ETML-ES-SLO/PRJ_2204_Theremin/doc/V2/Fonction_Generer_fre__Createur-0.png

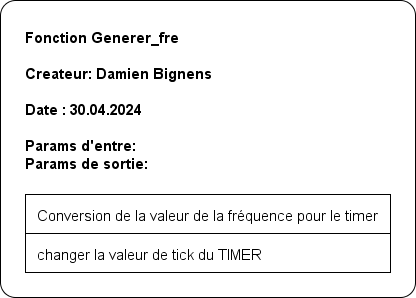
doc/V2/Fonction_Generer_fre__Createur-0.png
