ETML-ES-SLO/PRJ_2204_Theremin/doc/V2/Fonction_Lecture_capteur__Createur-0.png

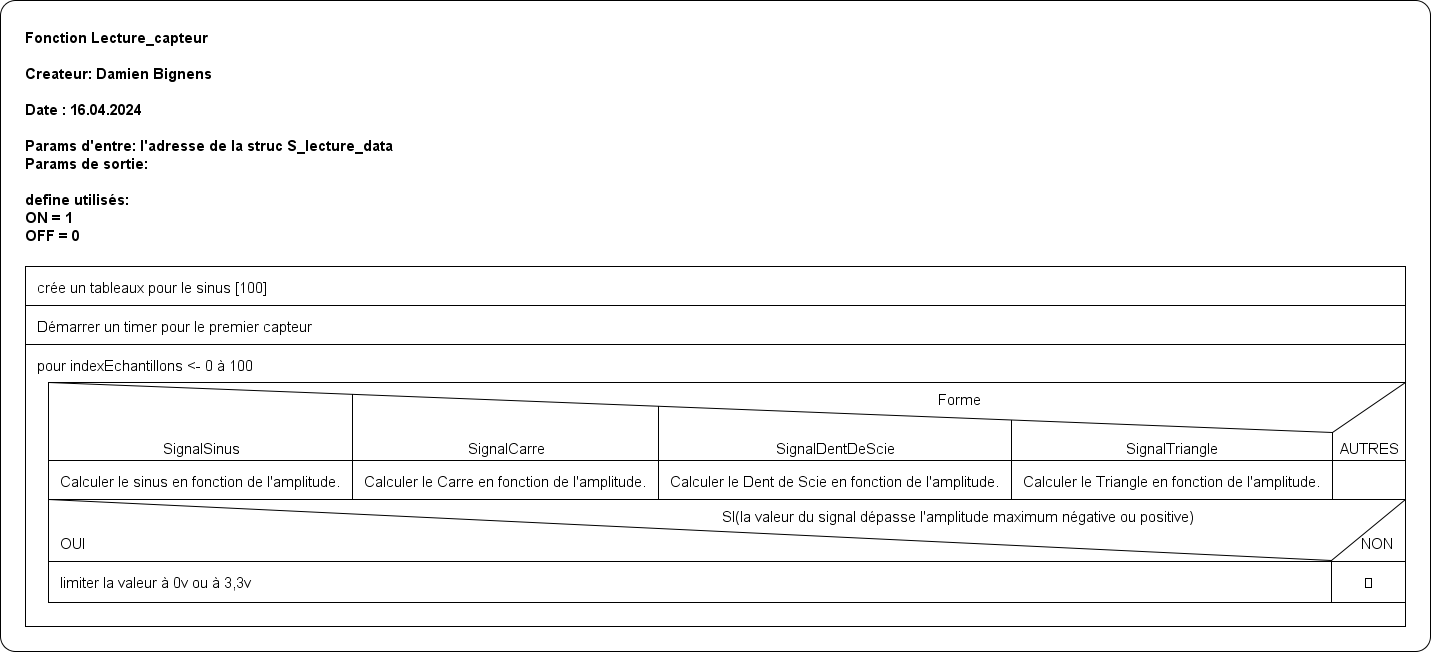
doc/V2/Fonction_Lecture_capteur__Createur-0.png
