ETML-ES-SLO/PRJ_2204_Theremin/doc/V2/Fonction_main__Createur-0.png

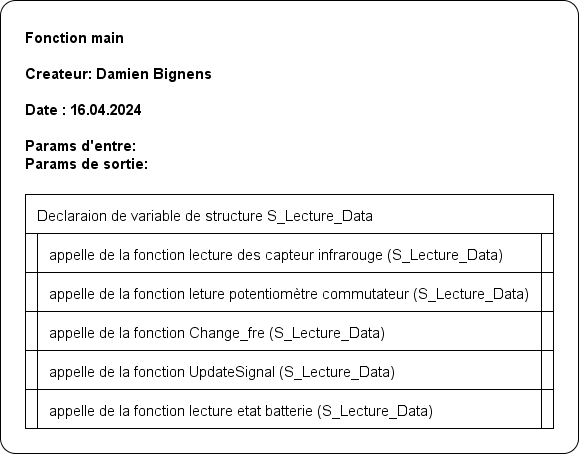
doc/V2/Fonction_main__Createur-0.png
