ETML-ES-SLO/PRJ_2204_Theremin/hard/3D/HC-SR04-UltrasonicSensor v7.step

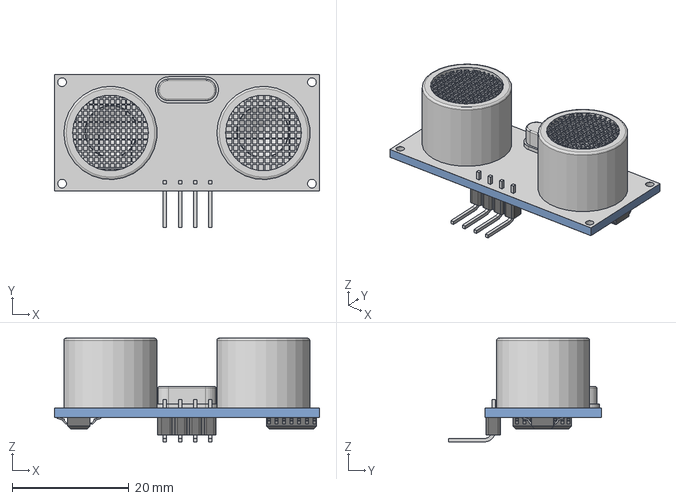
[picture p25: CAD file, 2024-05-14]
hard/3D/HC-SR04-UltrasonicSensor v7.step
45.5 x 26.2 x 17.8 mm
