ETML-ES-SLO/PRJ_2204_Theremin/mec/EvalSworks2022_Chafla/Boitier_Couvercle.SLDPRT

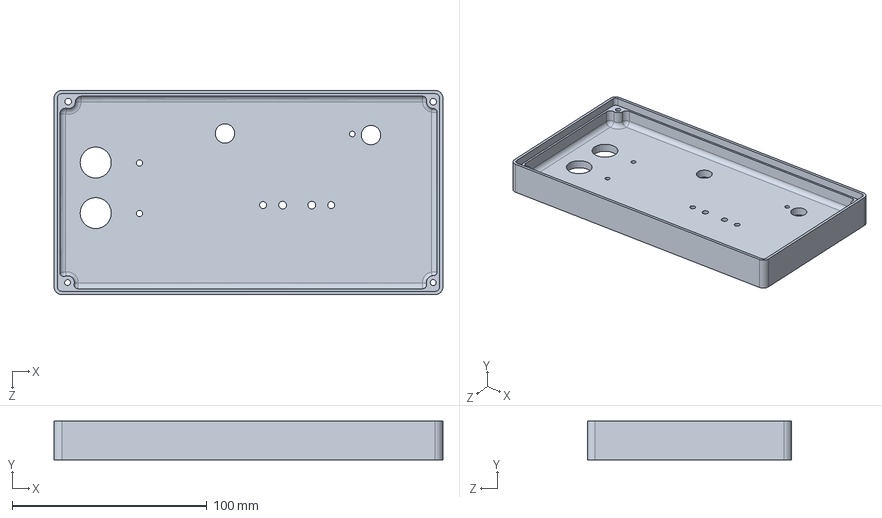
[picture p26: CAD file, 2024-05-14]
mec/EvalSworks2022_Chafla/Boitier_Couvercle.SLDPRT
200.0 x 20.0 x 105.0 mm
