ETML-ES-SLO/PRJ_2204_Theremin/hard/3D/PCB_Flex_Sensor_V.step

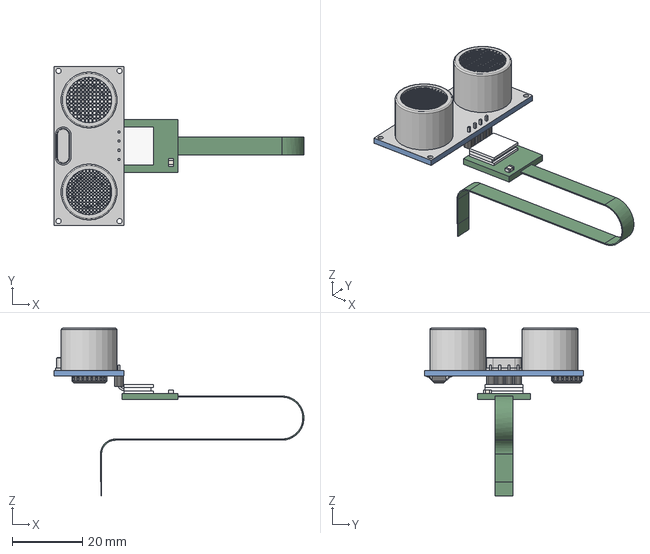
[picture p27: CAD file, 2024-05-14]
hard/3D/PCB_Flex_Sensor_V.step
71.3 x 45.5 x 47.8 mm
