ETML-ES-SLO/PRJ_2204_Theremin/mec/EvalSworks2022_Chafla/Boitier_Base.SLDPRT

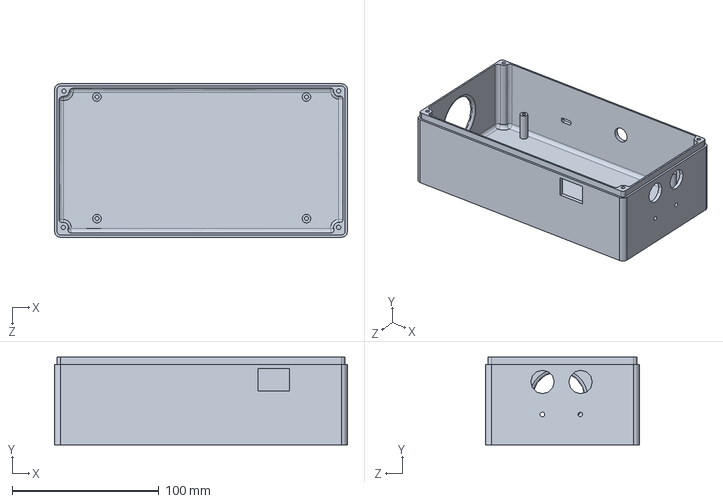
[picture p28: CAD file, 2024-05-14]
mec/EvalSworks2022_Chafla/Boitier_Base.SLDPRT
200.0 x 60.0 x 105.0 mm
