ETML-ES-SLO/PRJ_2204_Theremin/hard/3D/PCB_Flex_Sensor_H2.step

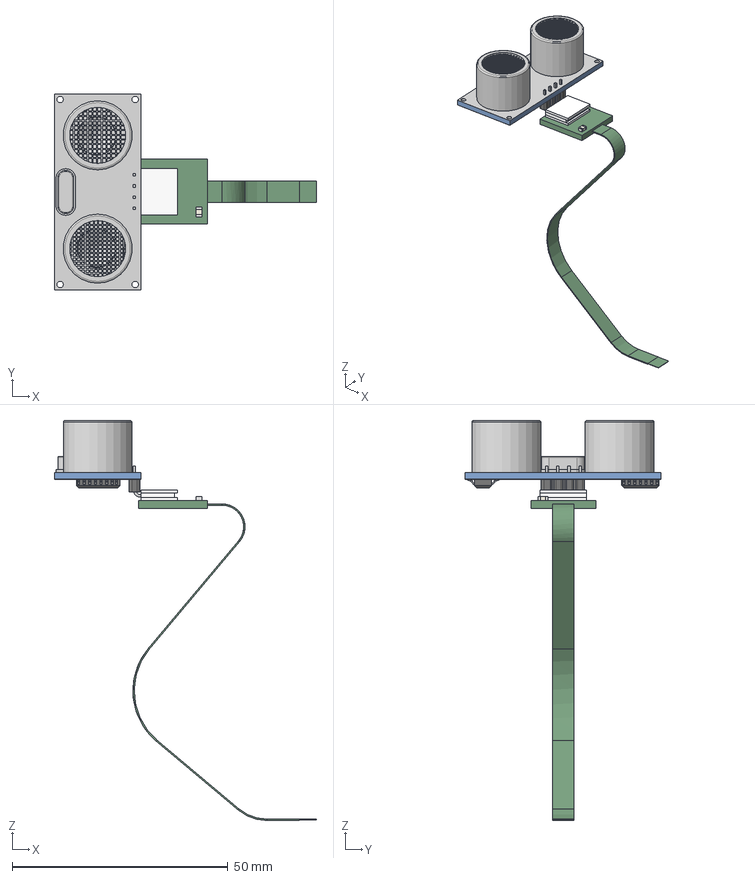
[picture p29: CAD file, 2024-05-14]
hard/3D/PCB_Flex_Sensor_H2.step
60.7 x 45.5 x 92.6 mm
Extruded x 6
HC-SR04-UltrasonicSensor_v7
