ETML-ES-SLO/PRJ_2204_Theremin/hard/3D/CUI_DEVICES_SJ-63073E.sldprt

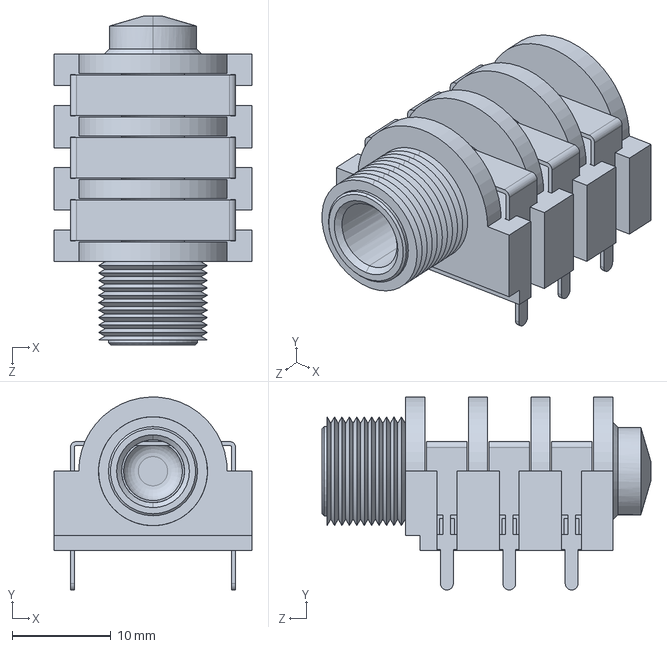
[picture p30: CAD file, 2024-05-14]
hard/3D/CUI_DEVICES_SJ-63073E.sldprt
20.0 x 19.5 x 33.2 mm
