ETML-ES-SLO/PRJ_2204_Theremin/hard/3D/PCB_Sensor_V2.step

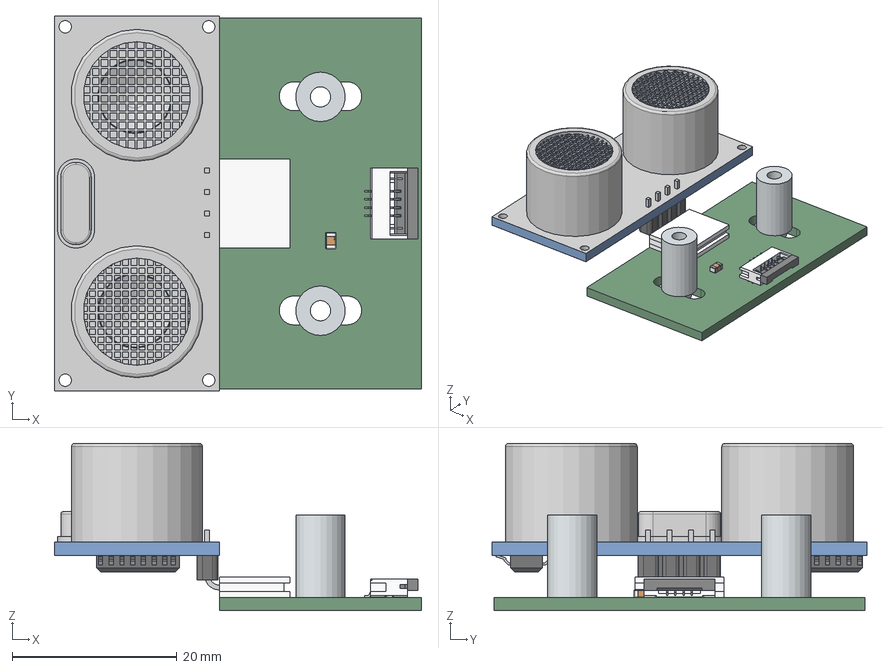
[picture p31: CAD file, 2024-05-14]
hard/3D/PCB_Sensor_V2.step
44.5 x 45.5 x 20.3 mm
6861xx148922_Patte
6861xx148922_Patte2
6861xx148922_Pin x 4
686104148922_Actuator
Extruded x 3
Terminals
Electrode
AVX
HC-SR04-UltrasonicSensor_v7
9774100360R_(rev1) x 2
