ETML-ES-SLO/PRJ_2204_Theremin/hard/3D/PCB_Flex_Sensor_H1.step

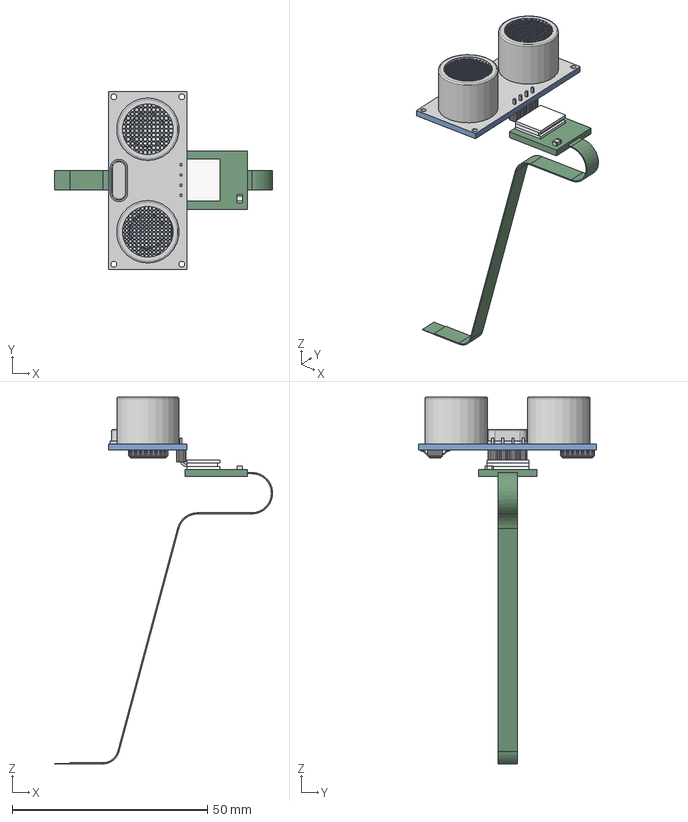
[picture p32: CAD file, 2024-05-14]
hard/3D/PCB_Flex_Sensor_H1.step
55.8 x 45.5 x 93.9 mm
Extruded x 6
HC-SR04-UltrasonicSensor_v7
