ETML-ES-SLO/PRJ_2204_Theremin/hard/3D/Sanjo NCR18650GA.SLDPRT

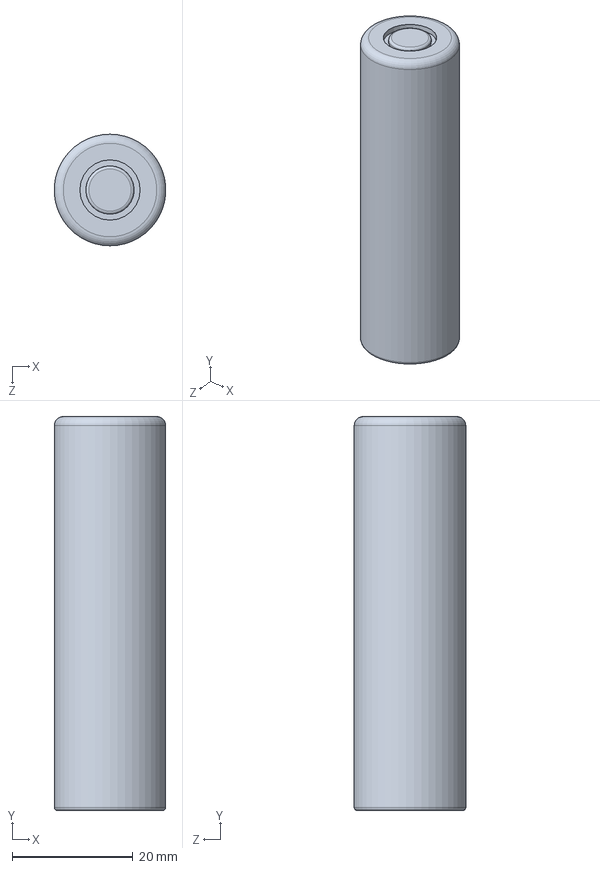
[picture p33: CAD file, 2024-05-14]
hard/3D/Sanjo NCR18650GA.SLDPRT
18.5 x 65.3 x 18.5 mm
