ETML-ES-SLO/PRJ_2204_Theremin/(list of files, cad)

Other CAD files:
hard/3D/Theremin-Boitier_JonathanCHAFLA-Couvercle.SLDPRT
hard/3D/Theremin-Boitier_JonathanCHAFLA.SLDPRT
mec/EvalSworks2022_Chafla/Mise-En-Plan.SLDDRW
