ETML-ES-SLO/PRJ_2204_Theremin/doc/V1/JournalDeTravail-PROJ_Chafla.xlsx

Journal de travail - Projet POBJ
Date | Tâche | Problème rencontré
2023-02-09 | Attribution des sujets de projets
2023-02-16 | Travail effectué pour autres branches suite à des rendus
2023-02-23 | Projet : étude du CdC projet 1737 | Cdc pas très claire
2023-03-02 | TE POBJ Cpp
2023-03-09 | Projet : étude du CdC projet 1737 | Projet pas possible à réaliser informé aux enseignants
2023-03-16 | Attribution nouveau projet Théremin -> reprise projet création dossier local K
2023-03-23 | Projet : étude du projet théremin | Compréhension du schéma
2023-03-30 | Projet : étude du projet théremin, explication fonctionnement des blocs du système
2023-04-06 | Travail effectué pour autres branches suite à des rendus
2023-04-13 | Vacances
2023-04-20 | Vacances
2023-04-27 | TE POBJ C#
2023-05-04 | Projet : étude des périphériques software, design flowcharts
2023-05-11 | Correction test suite à rendu
2023-05-18 | Ascension
2023-05-25 | Projet : mise en forme rapport pour rendu
2023-06-01 | Rendu finale
