ETML-ES-SLO/PRJ_2204_Theremin/hard/Project Outputs for Theremin_Project/DesignDocs/Schematic Prints.PDF

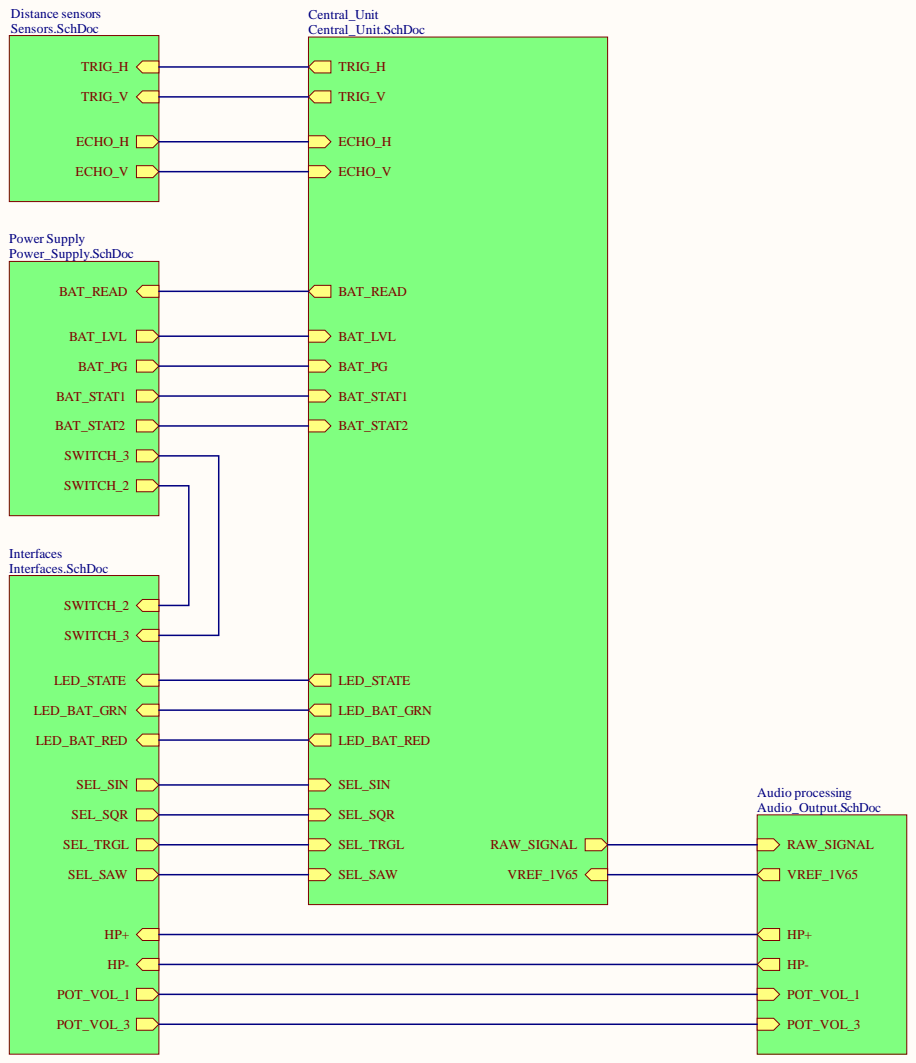
[picture p34: page 1]

Schema_bloc.SchDoc Fichier : | | a

Date : 22.06.2022 | Version :

Heure : 14:36:07 | Auteur : *
Avenue Recordon 1 1004 Lausanne Switzerland | Projet : Theremin_Project.PrjPcb | No :

Nb feuilles | Feuille n°

Chemin : C:\Users\jonchafla\OneDrive - Education Vaud\Users\Jonathan Chafla\ETML\ES\21-22\PCAO\Theremin_Jonathan_Chafla\Schema_bloc.SchDoc

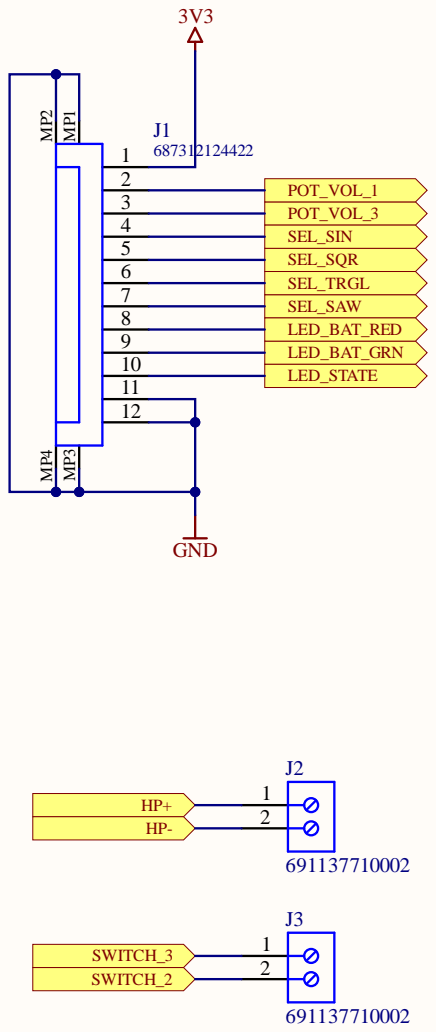
[picture p35: page 2]

Interfaces.SchDoc Fichier : | a

Date : 22.06.2022 | Version :

M.Ricchieri

Chemin : C:\Users\jonchafla\OneDrive - Education Vaud\Users\Jonathan Chafla\ETML\ES\21-22\PCAO\Theremin_Jonathan_Chafla\Interfaces.SchDoc

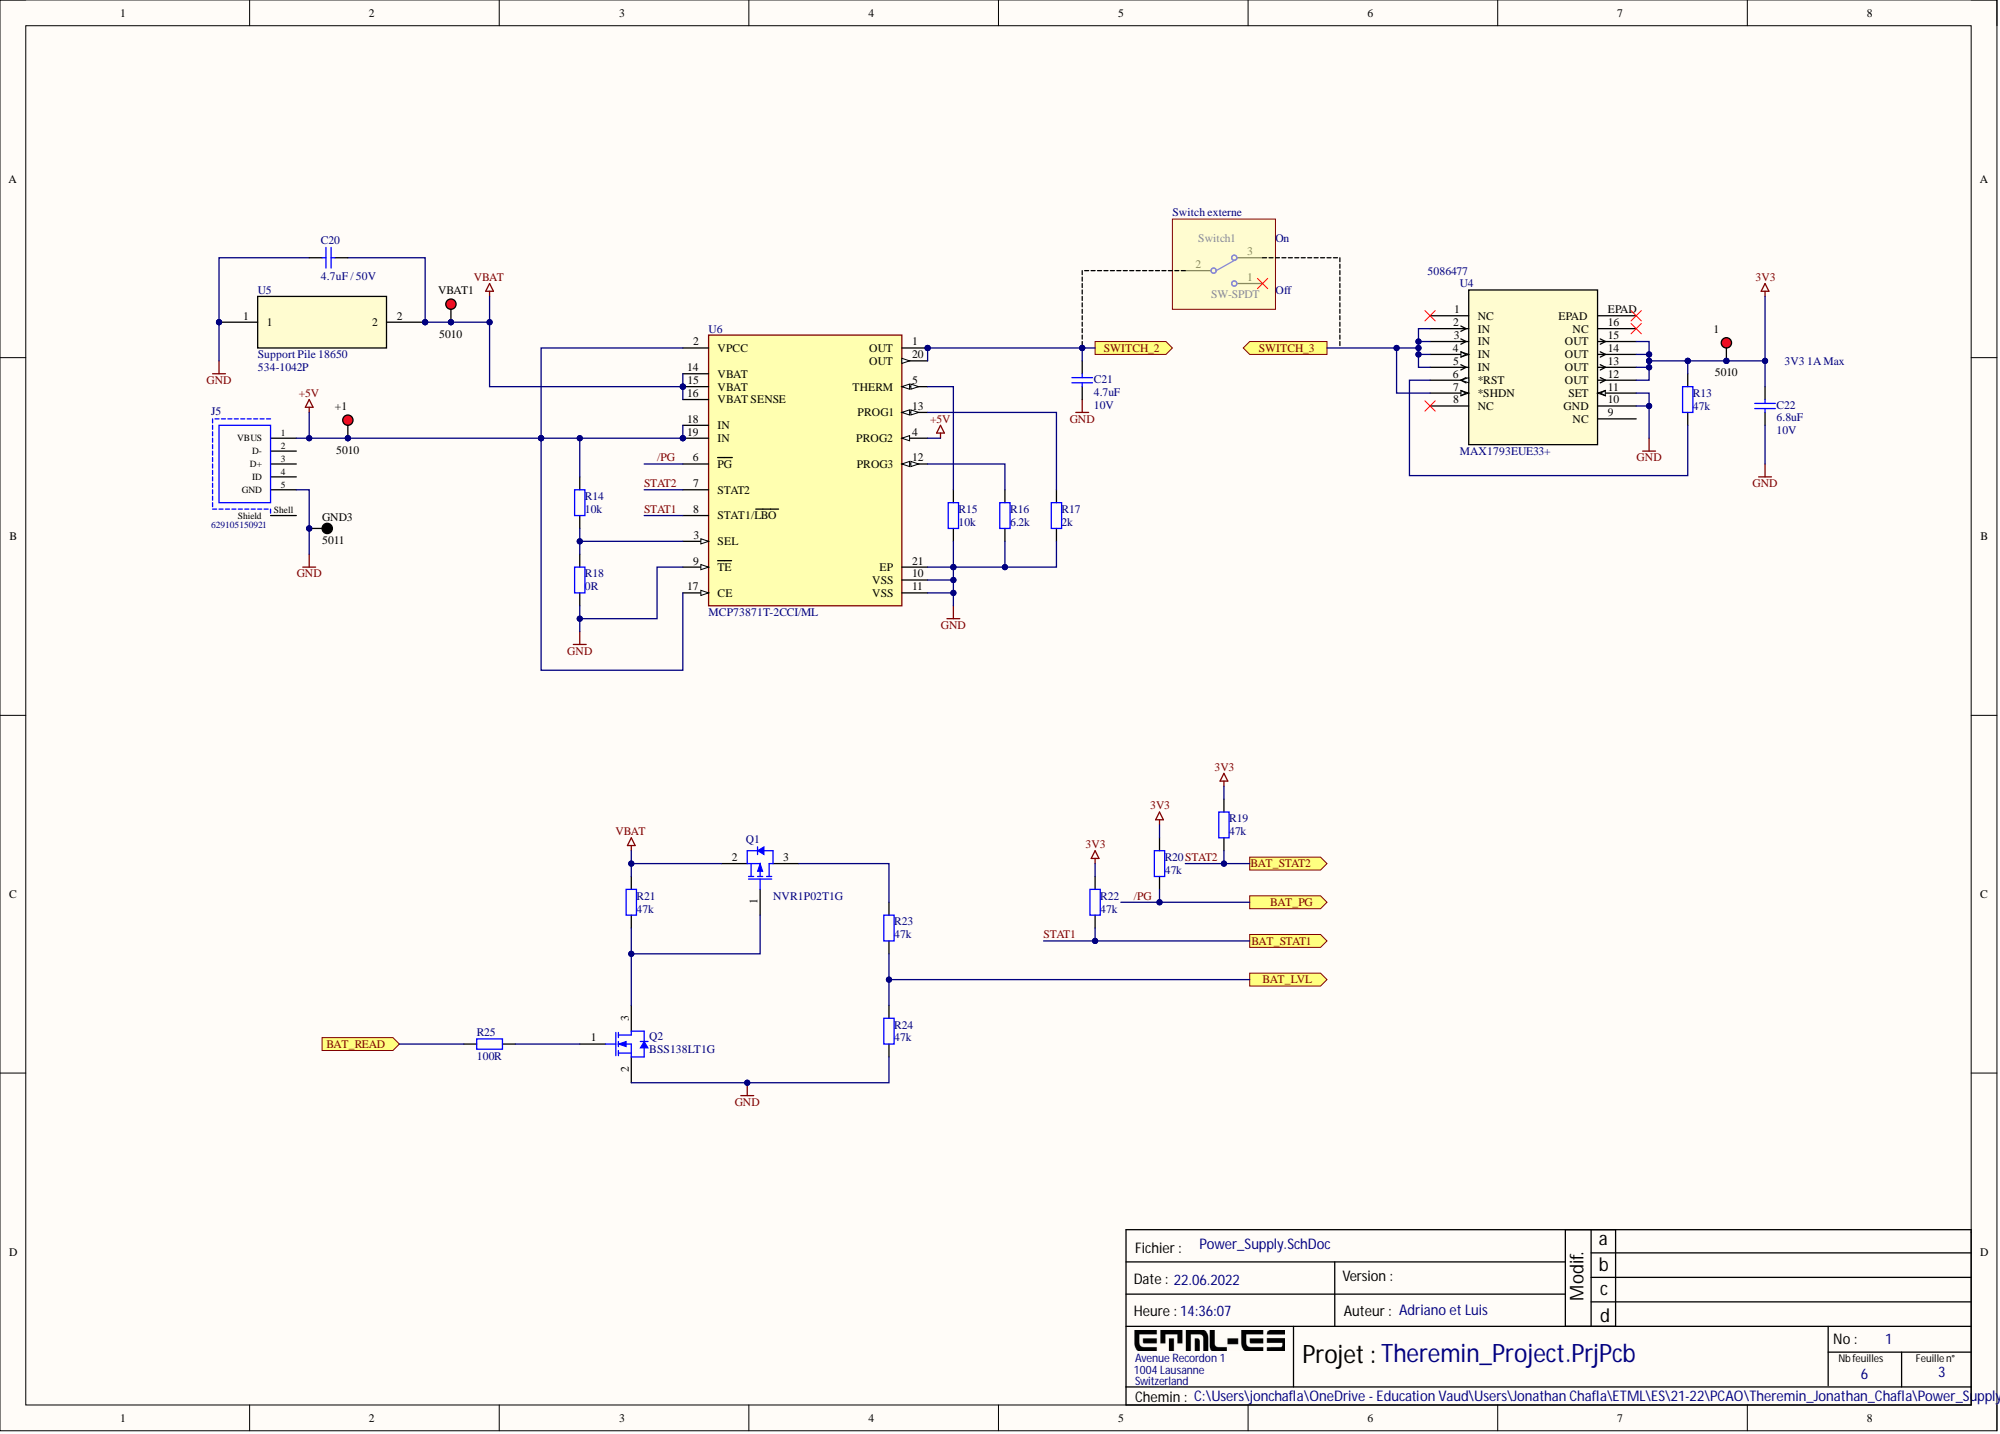
[picture p36: page 3]

*SHDN 7

Power_Supply.SchDoc Fichier : | a

Date : 22.06.2022 | Version :

Adriano et Luis

Chemin : C:\Users\jonchafla\OneDrive - Education Vaud\Users\Jonathan Chafla\ETML\ES\21-22\PCAO\Theremin_Jonathan_Chafla\Power_Supply.SchDoc

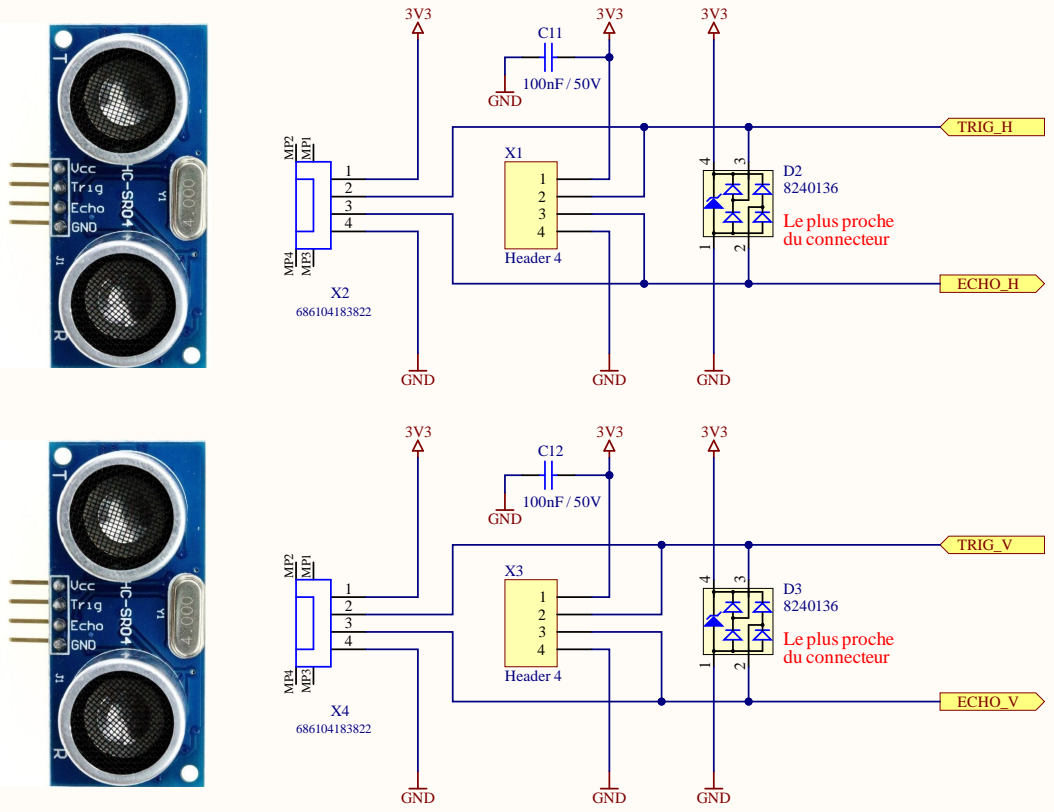
[picture p37: page 4]

Sensors.SchDoc Fichier : | a

Date : 22.06.2022 | Version : A

Einar / Taulant

Chemin : C:\Users\jonchafla\OneDrive - Education Vaud\Users\Jonathan Chafla\ETML\ES\21-22\PCAO\Theremin_Jonathan_Chafla\Sensors.SchDoc

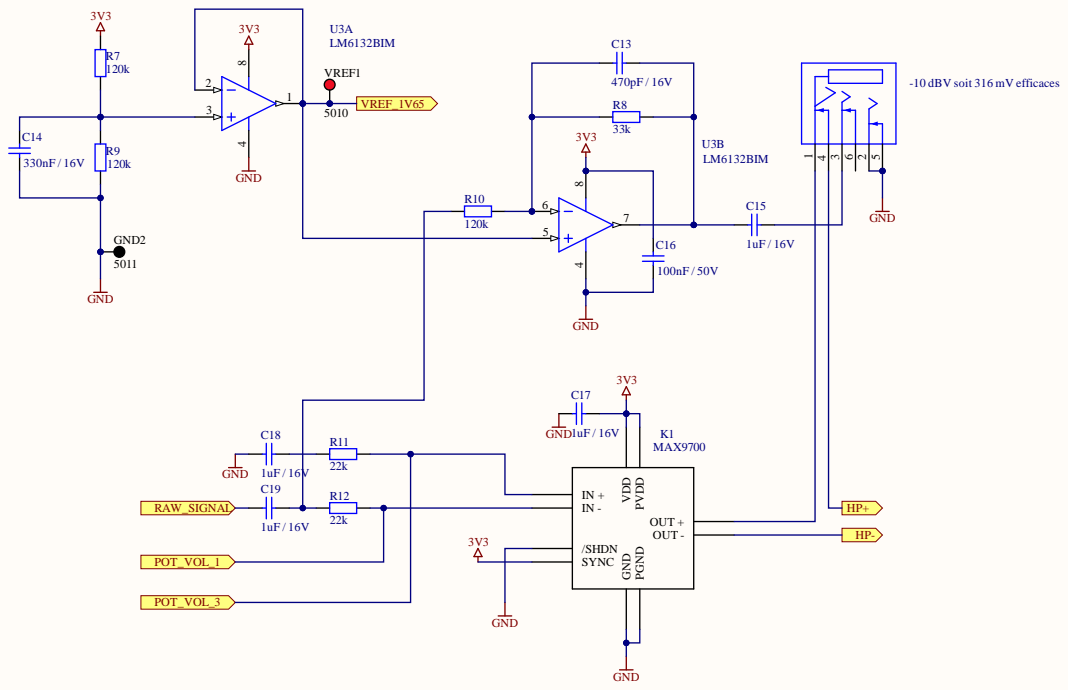
[picture p38: page 5]

-10 dBV soit 316 mV efficaces

Audio_Output.SchDoc Fichier : | a

Date : 22.06.2022 | Version :

Samuel Pittton&co

Chemin : C:\Users\jonchafla\OneDrive - Education Vaud\Users\Jonathan Chafla\ETML\ES\21-22\PCAO\Theremin_Jonathan_Chafla\Audio_Output.SchDoc

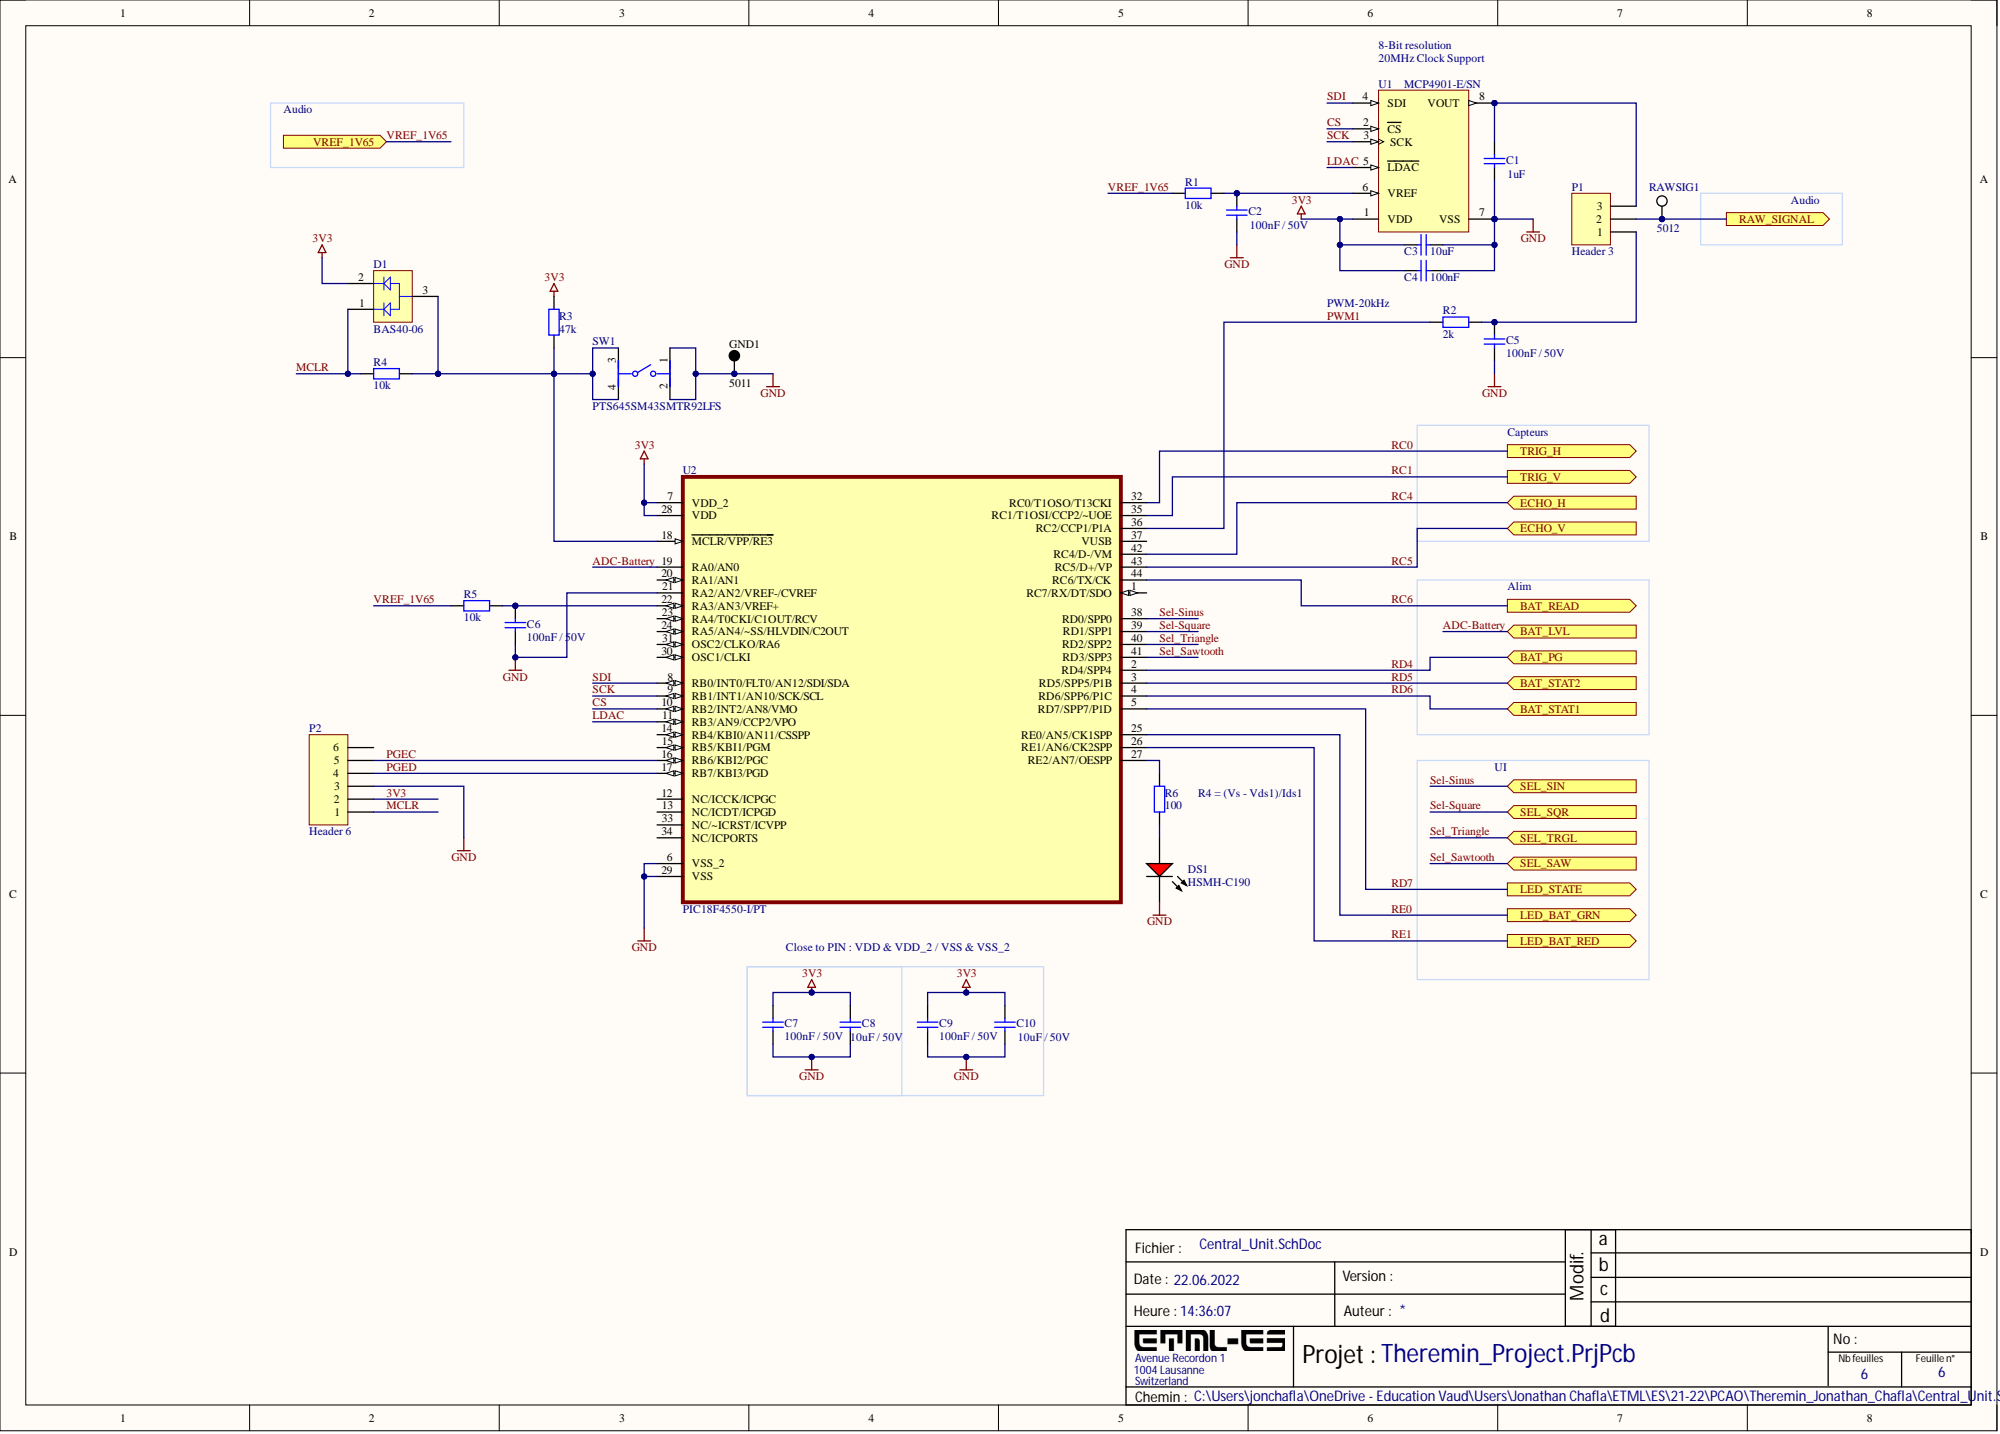
[picture p39: page 6]

2 8 | 3 5
1 8 | 3 6

1 | RC6 | BAT _ LV L BAT _STAT 2

C6 100 nF / 5 0 V | 2 3 | Sel-Si n u s Sel-Sq uar e Sel _ Trian g l e Sel _Saw t o o th | A DC-Bat t ery

Cent ral_Unit . SchDoc Fichier :

Date : 22.06.2022 | Version :

Avenue Re cordon 1 004 Lausanne Switzerland | Projet

Nb feuille s | F euille n°

Chemin : C:\Users\jonchafla\OneDrive - Education Vaud\Users\Jonathan Chafla\E
