ETML-ES-SLO/PRJ_2204_Theremin/hard/Project Outputs for Theremin_Project/DesignDocs/Dimensional Drawings.PDF

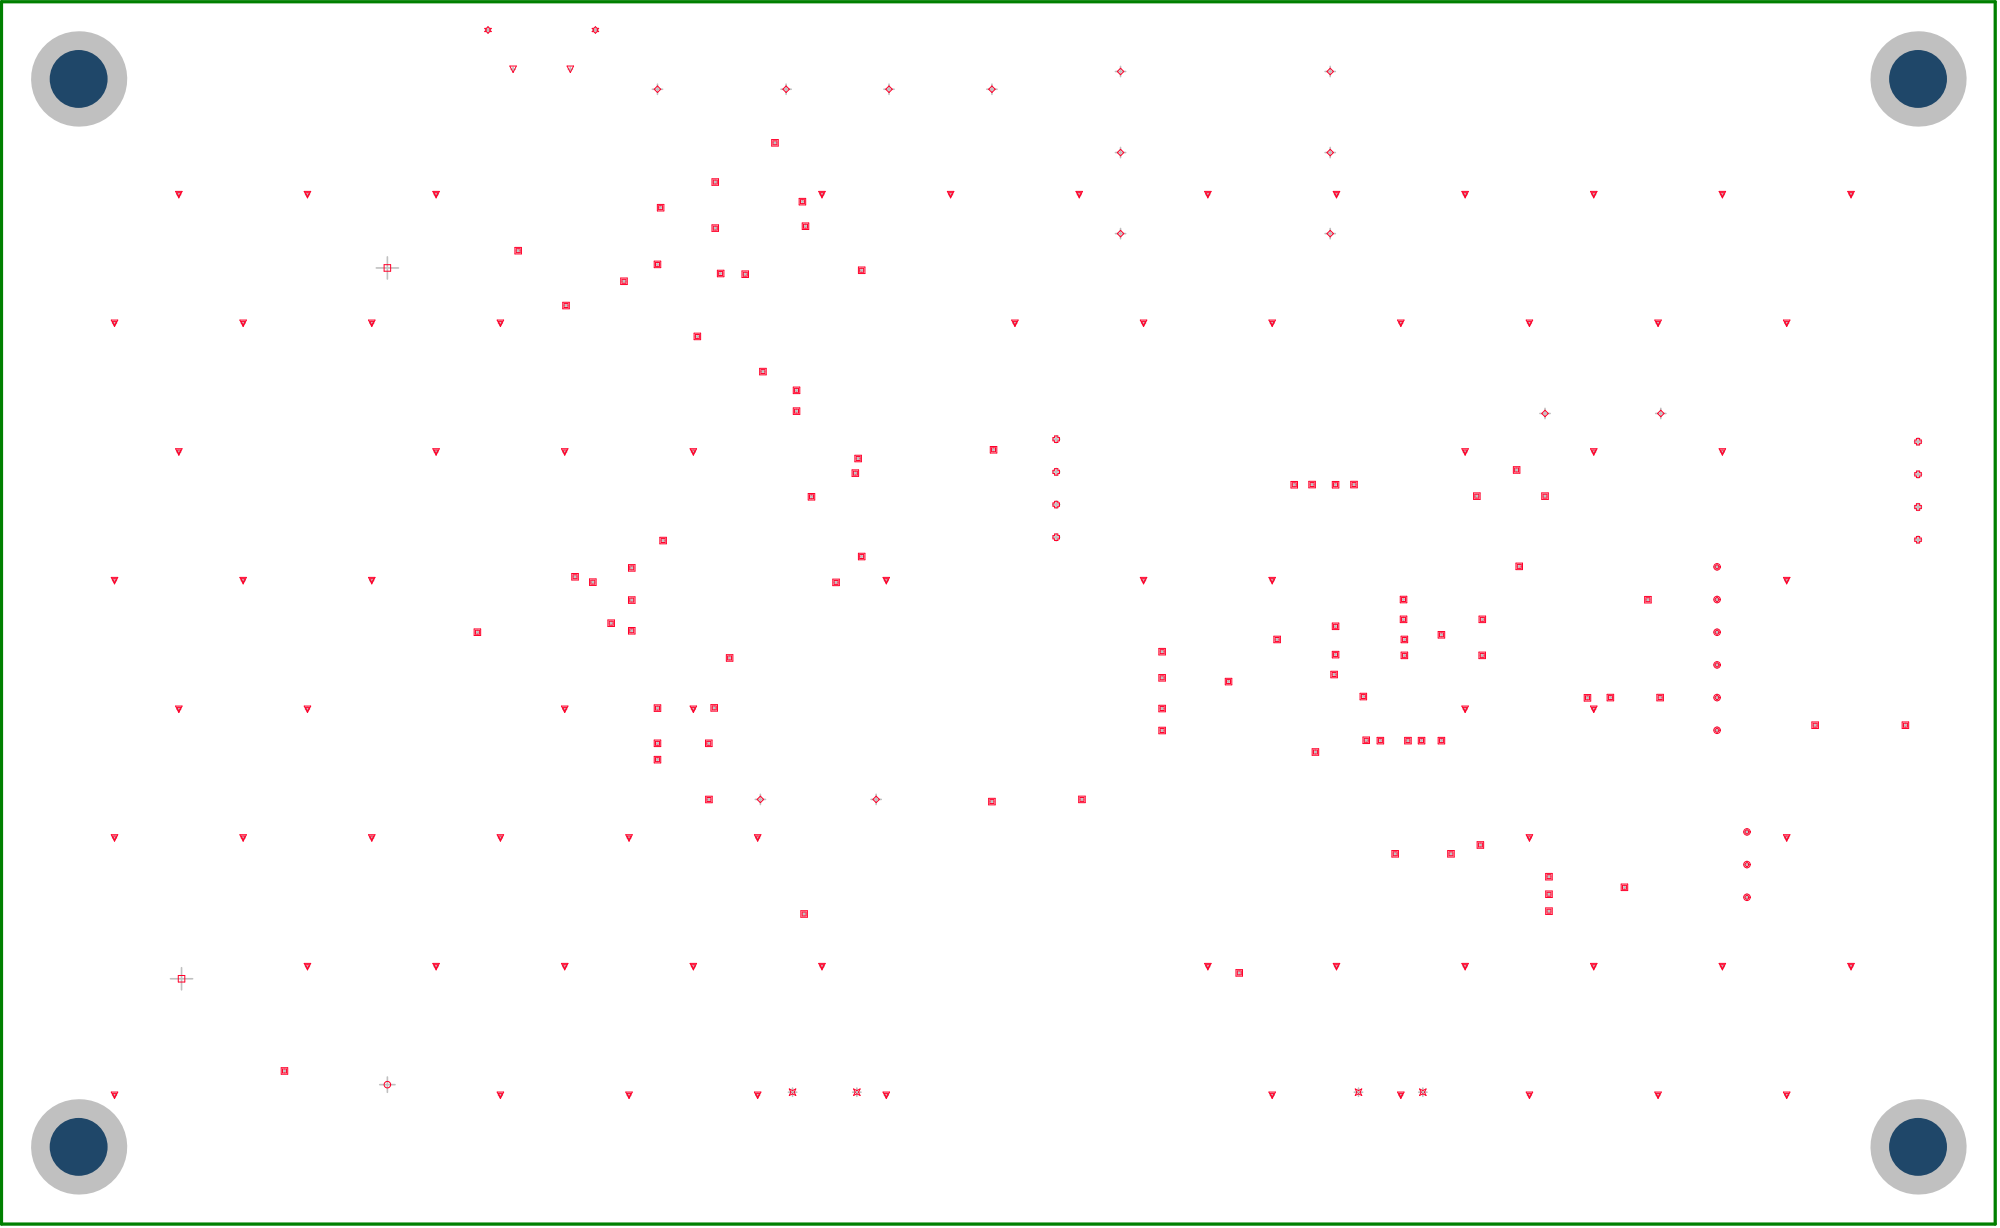
[picture p40: page 1]
