ETML-ES-SLO/PRJ_2204_Theremin/hard/Project Outputs for Theremin_Project/DesignDocs/PCB Top-Bottom Assy Dwgs.PDF

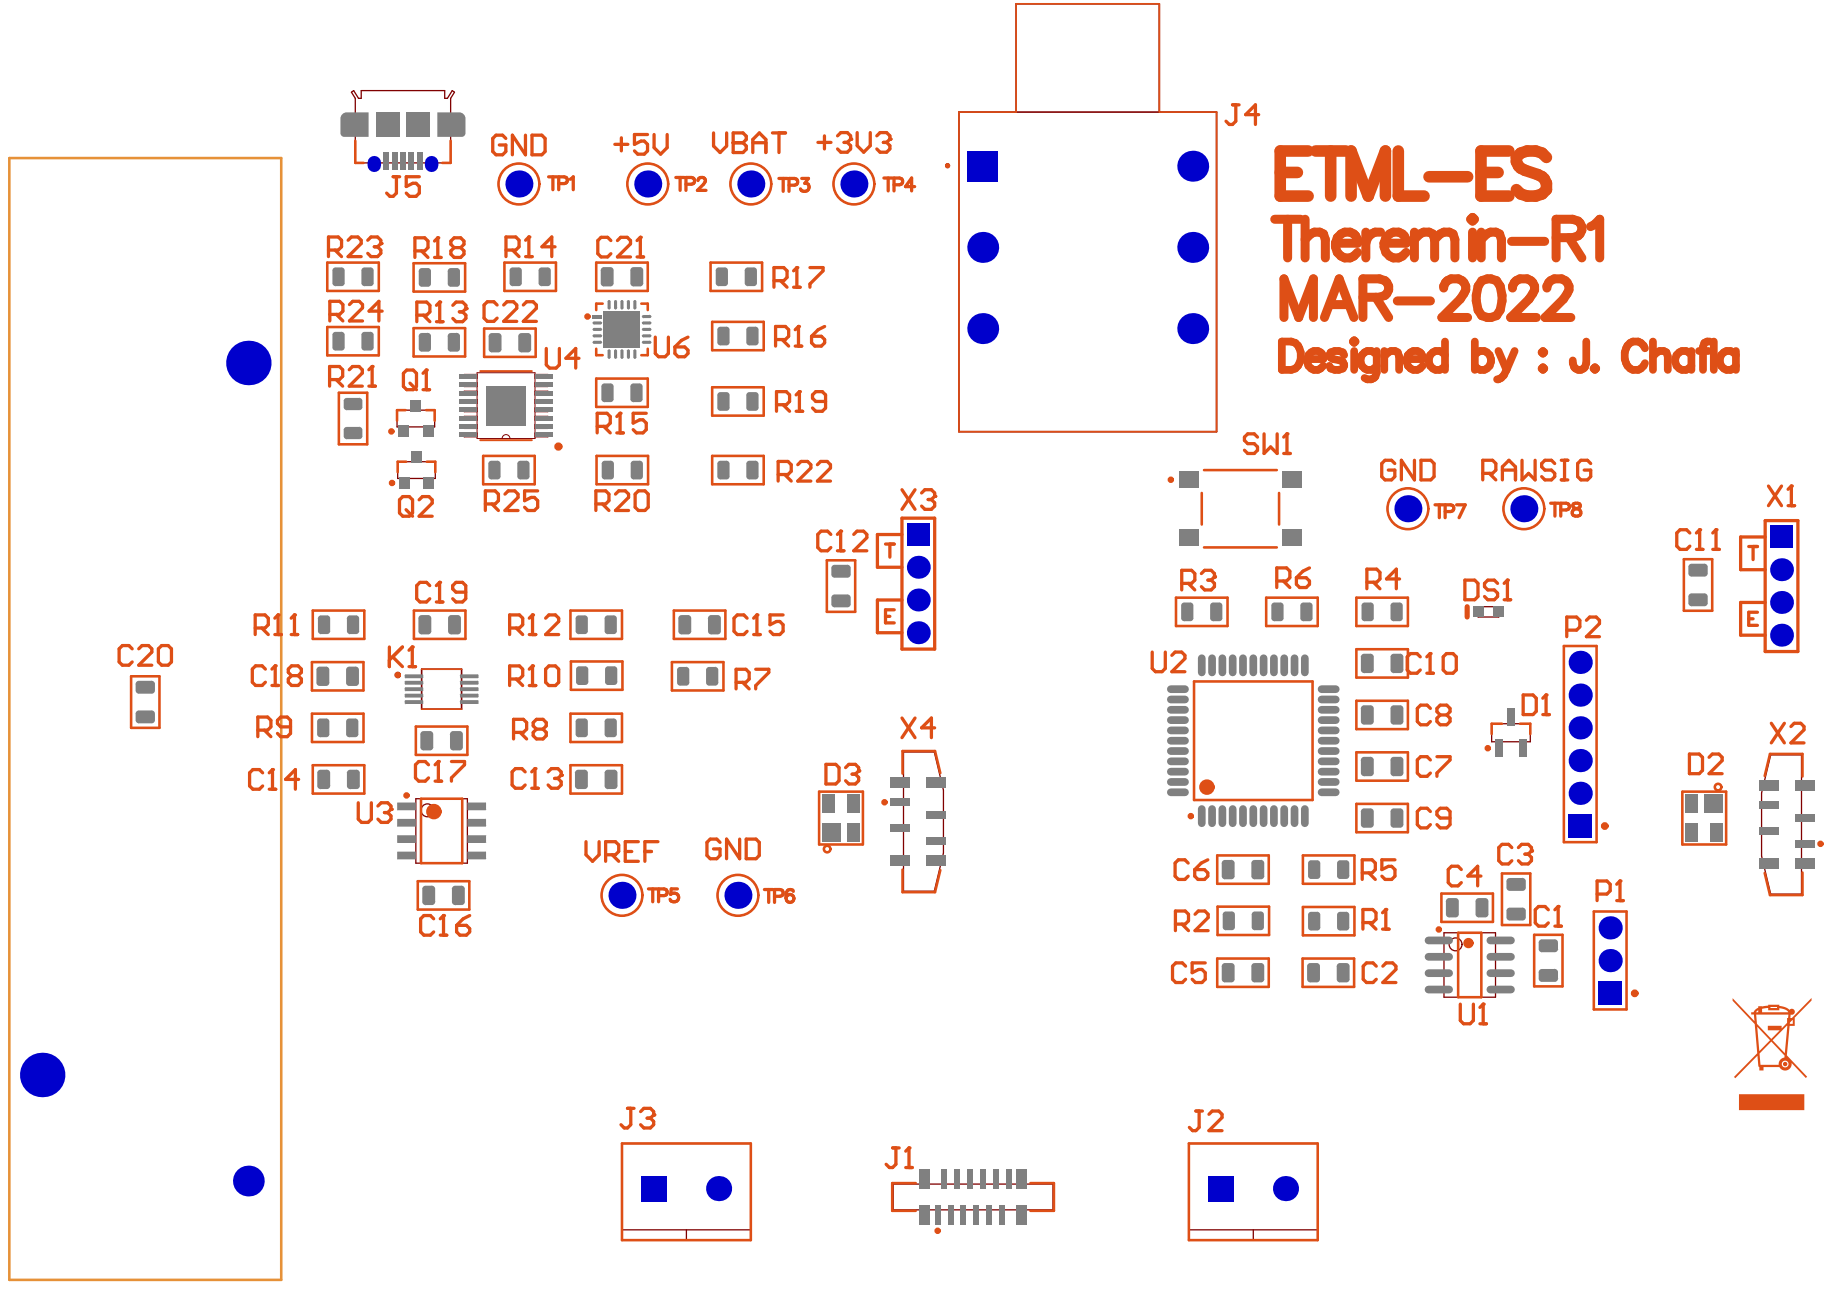
[picture p41: page 1]

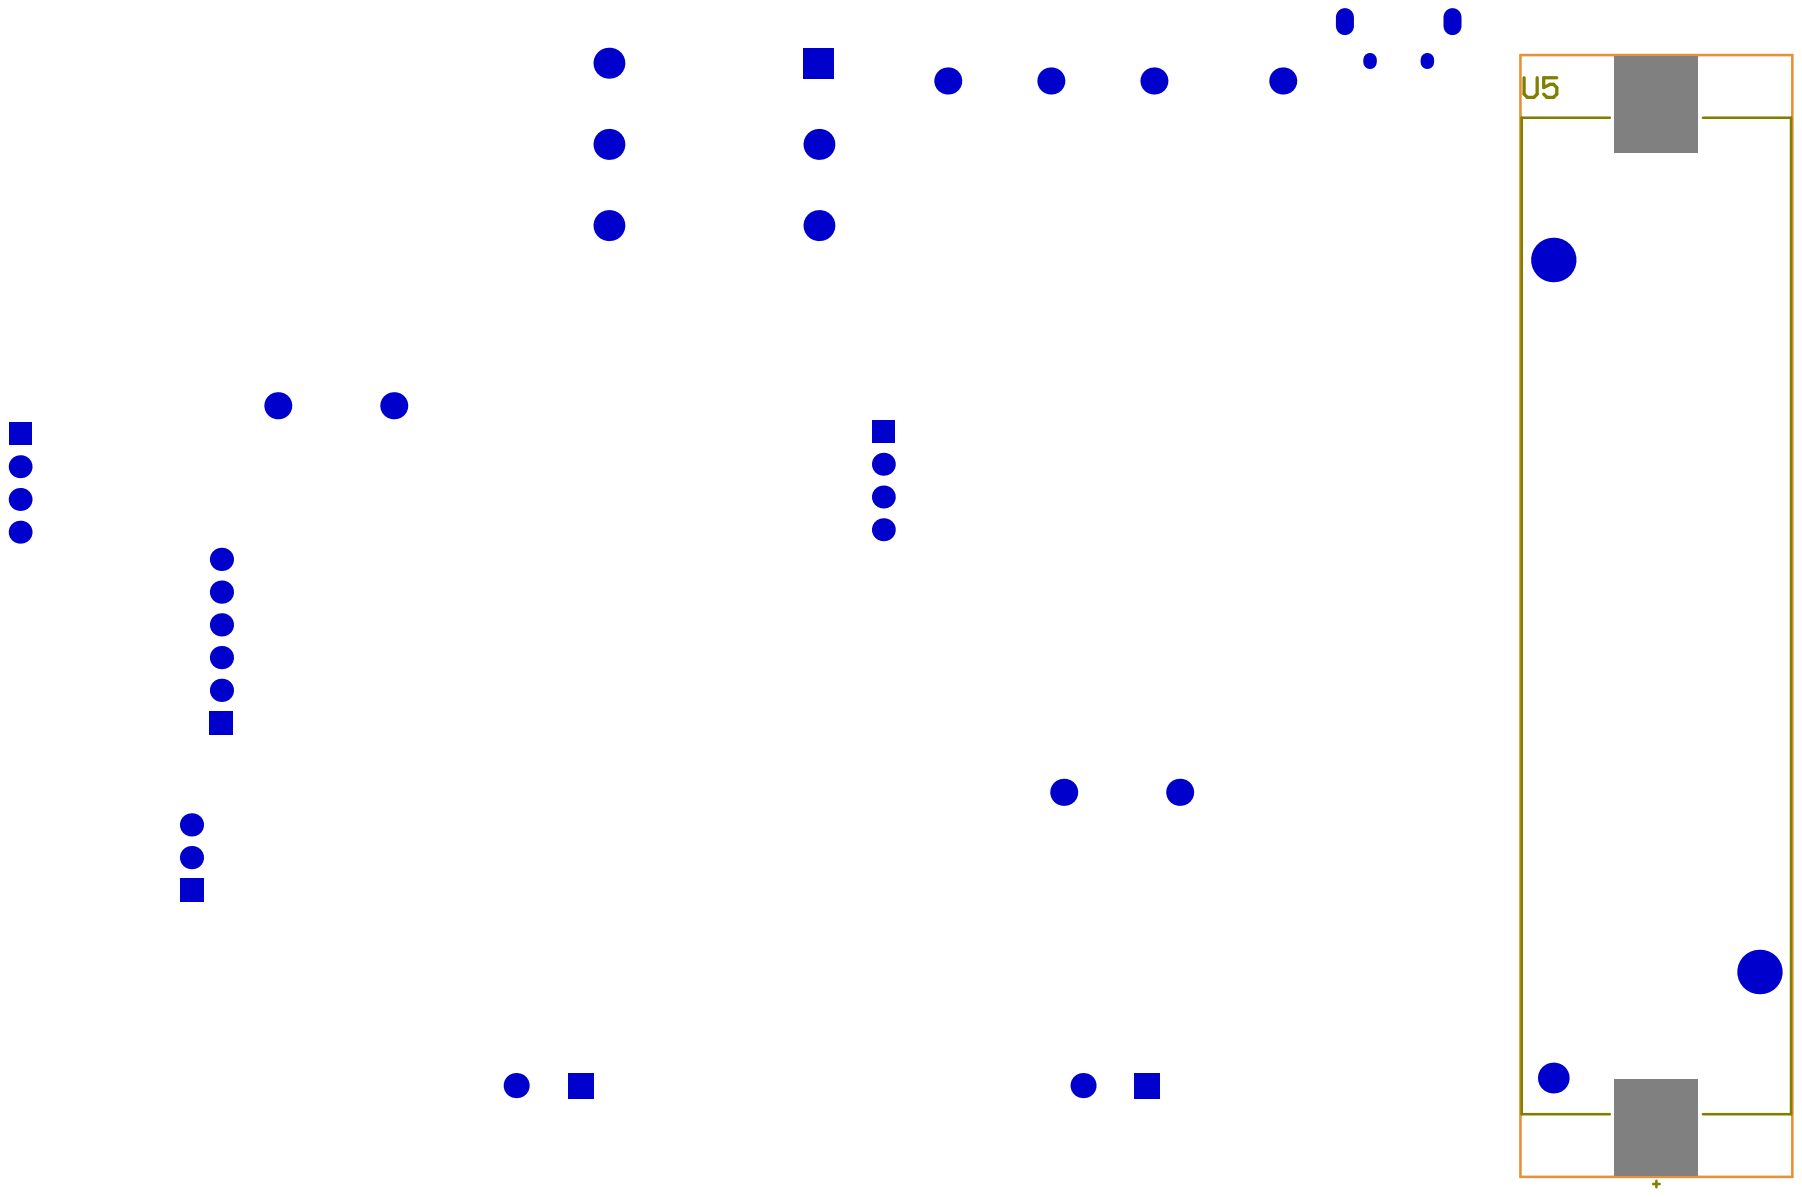
[picture p42: page 2]
