ETML-ES-SLO/PRJ_2204_Theremin/(list of files, drawings)

Other design files:
hard/Audio_Output.SchDoc
hard/Central_Unit.SchDoc
hard/Interfaces.SchDoc
hard/Power_Supply.SchDoc
hard/Schema_bloc.SchDoc
hard/Sensors.SchDoc
hard/Theremin_Project.PrjPcb
