ETML-ES-SLO/PRJ_2204_Theremin/(commit log)

2024-05-14 first update Github
    [Audio_Output.SchDoc, Boitier_Base.SLDPRT, Boitier_Couvercle.SLDPRT, CUI_DEVICES_SJ-63073E.sldprt, Central_Unit.SchDoc, GestionPorts.xlsx, HC-SR04-UltrasonicSensor v7.step, Interfaces.SchDoc]
2025-06-26 MAJ PRJ 2204 - BY TCT
    [Central_Unit.SchDoc, GestionPorts.xlsx, JournalDeTravail-PROJ_Chafla.xlsx, Theremin_Project.PrjPcb, configuration_bitsSettings.h]
